HarkonenBade/porta-jelly/README.md

# porta-jelly

Rework of @cillian64 's excellent mini-jelly board (https://github.com/cillian64/cyberjelly/tree/master/mini_jellies/mini_jellies) tweaked to include an IP5306 based Lipo charge and boost setup to make a portable LED strip driving system with built in battery charging.
