HarkonenBade/porta-jelly/porta-jelly.pdf

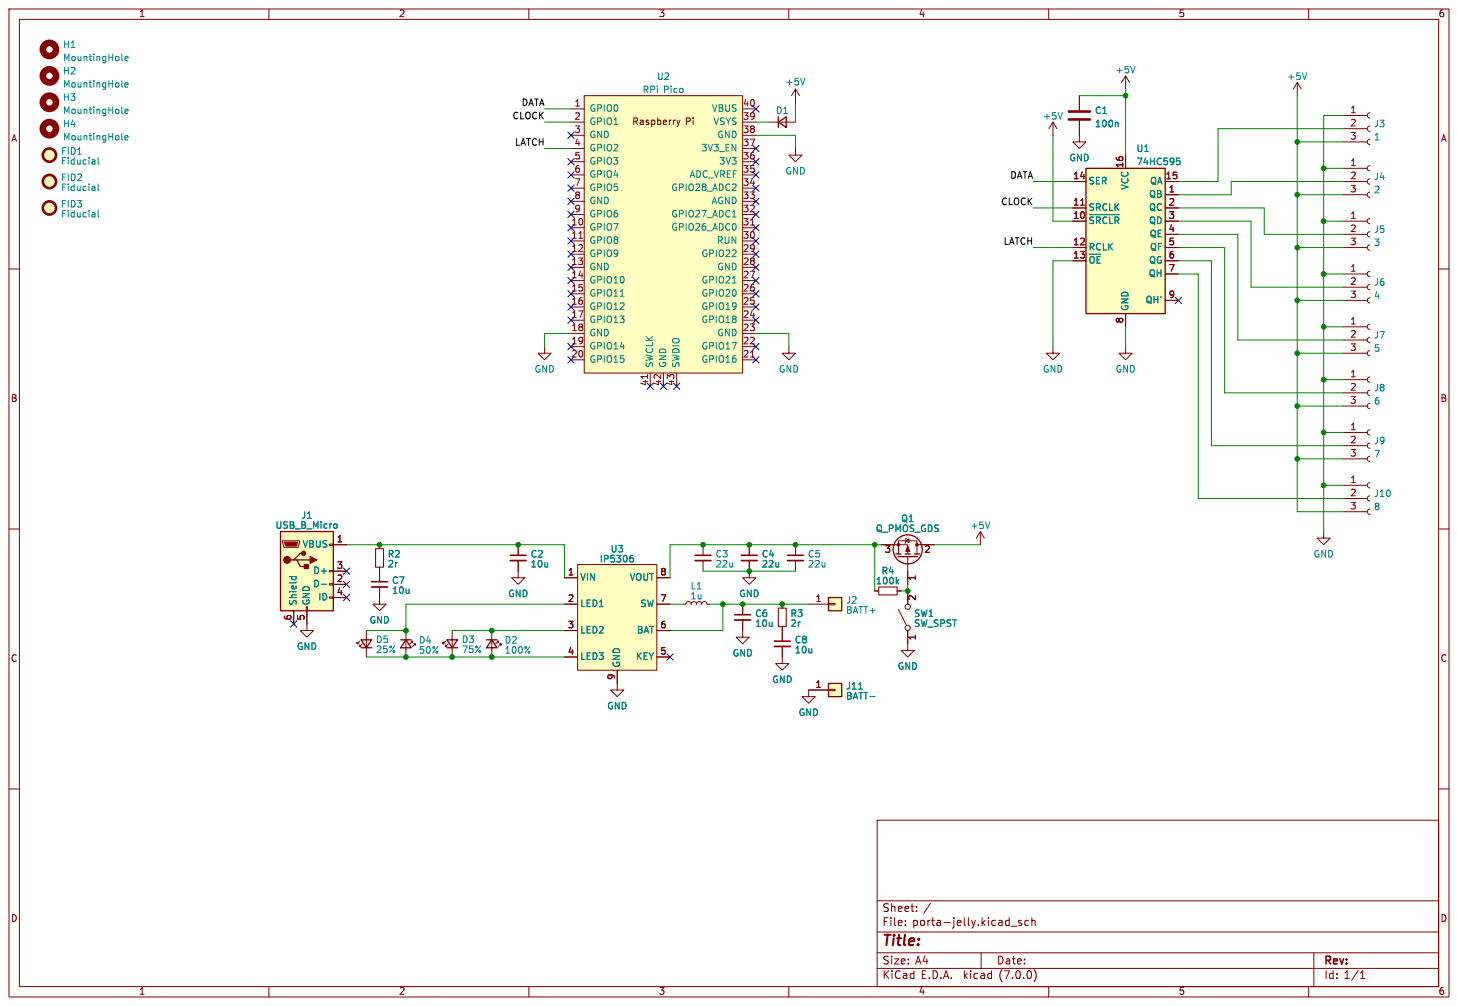
[picture p1: page 1]
