HarkonenBade/porta-jelly/porta-jelly.kicad_pcb

## KiCad design porta-jelly.kicad_pcb (2023-03-20)

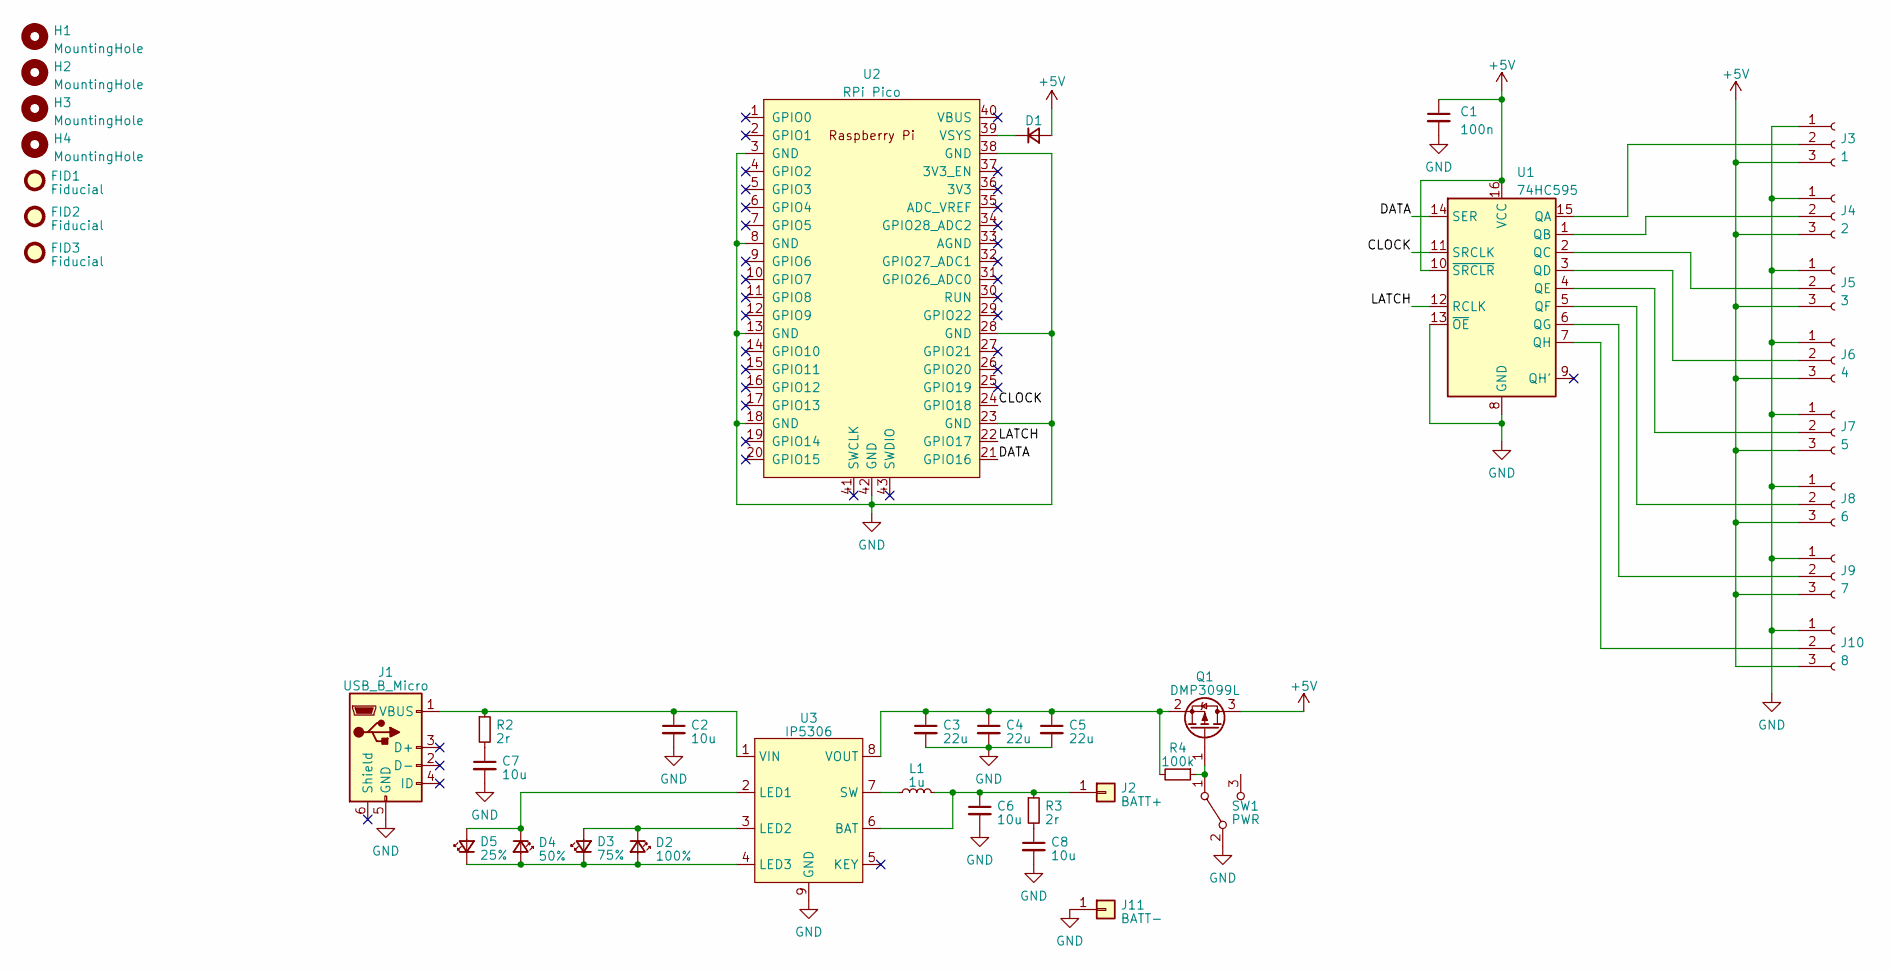
[picture p2: schematic porta-jelly.kicad_sch]

Parts:
C1: 100n; C_0603_1608Metric
C2, C6, C7, C8: 10u; C_0603_1608Metric; LCSC C19702
C3, C4, C5: 22u; C_0805_2012Metric; LCSC C159801
D1: D_Small; D_0805_2012Metric; LCSC C146335
D2: 100%; LED_0805_2012Metric; LCSC C497961
D3: 75%; LED_0805_2012Metric; LCSC C497961
D4: 50%; LED_0805_2012Metric; LCSC C497961
D5: 25%; LED_0805_2012Metric; LCSC C497961
FID1, FID2, FID3: Fiducial; Fiducial_1mm_Mask2mm
H1, H2, H3, H4: MountingHole; MountingHole_3.2mm_M3
J1: USB_B_Micro; USB_Micro-B_Molex-105017-0001; LCSC C136000
J2: BATT+; Bonded_Pad
J3: 1; Molex_KK-254_AE-6410-03A_1x03_P2.54mm_Vertical
J4: 2; Molex_KK-254_AE-6410-03A_1x03_P2.54mm_Vertical
J5: 3; Molex_KK-254_AE-6410-03A_1x03_P2.54mm_Vertical
J6: 4; Molex_KK-254_AE-6410-03A_1x03_P2.54mm_Vertical
J7: 5; Molex_KK-254_AE-6410-03A_1x03_P2.54mm_Vertical
J8: 6; Molex_KK-254_AE-6410-03A_1x03_P2.54mm_Vertical
J9: 7; Molex_KK-254_AE-6410-03A_1x03_P2.54mm_Vertical
J10: 8; Molex_KK-254_AE-6410-03A_1x03_P2.54mm_Vertical
J11: BATT-; Bonded_Pad
L1: 1u; LQH44PH1R0MPRL; LCSC C1857967
Q1: DMP3099L; SOT-23; LCSC C155244
R2, R3: 2r; R_0603_1608Metric; LCSC C307263
R4: 100k; R_0603_1608Metric
SW1: PWR; SK12D07VG5; LCSC C3020419
U1: 74HC595; SOIC-16_3.9x9.9mm_P1.27mm; LCSC C5947
U2: RPi Pico; RPi_Pico_SMD_TH
U3: IP5306; SOIC-8-1EP_3.9x4.9mm_P1.27mm_EP2.29x3mm_ThermalVias; LCSC C181692

Connections:
+5V: C1.1, D1.2 (A), J3.3, J4.3, J5.3, J6.3, J7.3, J8.3, J9.3, J10.3, Q1.3 (D), U1.10 (~SRCLR), U1.16 (VCC)
/CLOCK: U1.11 (SRCLK), U2.24 (GPIO18)
/DATA: U1.14 (SER), U2.21 (GPIO16)
/LATCH: U1.12 (RCLK), U2.22 (GPIO17)
GND: C1.2, C2.2, C3.2, C4.2, C5.2, C6.2, C7.2, C8.2, J1.5 (GND), J3.1, J4.1, J5.1, J6.1, J7.1, J8.1, J9.1, J10.1, J11.1, SW1.2 (B), U1.8 (GND), U1.13 (~OE), U2.3 (GND), U2.8 (GND), U2.13 (GND), U2.18 (GND), U2.23 (GND), U2.28 (GND), U2.38 (GND), U2.42 (GND), U3.9 (GND)
unnamed: C7.1, R2.2
unnamed: C8.1, R3.2
unnamed: D1.1 (K), U2.39 (VSYS)
unnamed: D2.2 (A), D3.1 (K), D4.2 (A), D5.1 (K), U3.4 (LED3)
unnamed: D2.1 (K), D3.2 (A), U3.3 (LED2)
unnamed: D4.1 (K), D5.2 (A), U3.2 (LED1)
unnamed: C2.1, J1.1 (VBUS), R2.1, U3.1 (VIN)
unnamed: C6.1, J2.1, L1.2, R3.1, U3.6 (BAT)
unnamed: J3.2, U1.15 (QA)
unnamed: J4.2, U1.1 (QB)
unnamed: J5.2, U1.2 (QC)
unnamed: J6.2, U1.3 (QD)
unnamed: J7.2, U1.4 (QE)
unnamed: J8.2, U1.5 (QF)
unnamed: J9.2, U1.6 (QG)
unnamed: J10.2, U1.7 (QH)
unnamed: Q1.1 (G), R4.1, SW1.1 (A)
unnamed: C3.1, C4.1, C5.1, Q1.2 (S), R4.2, U3.8 (VOUT)
unnamed: L1.1, U3.7 (SW)

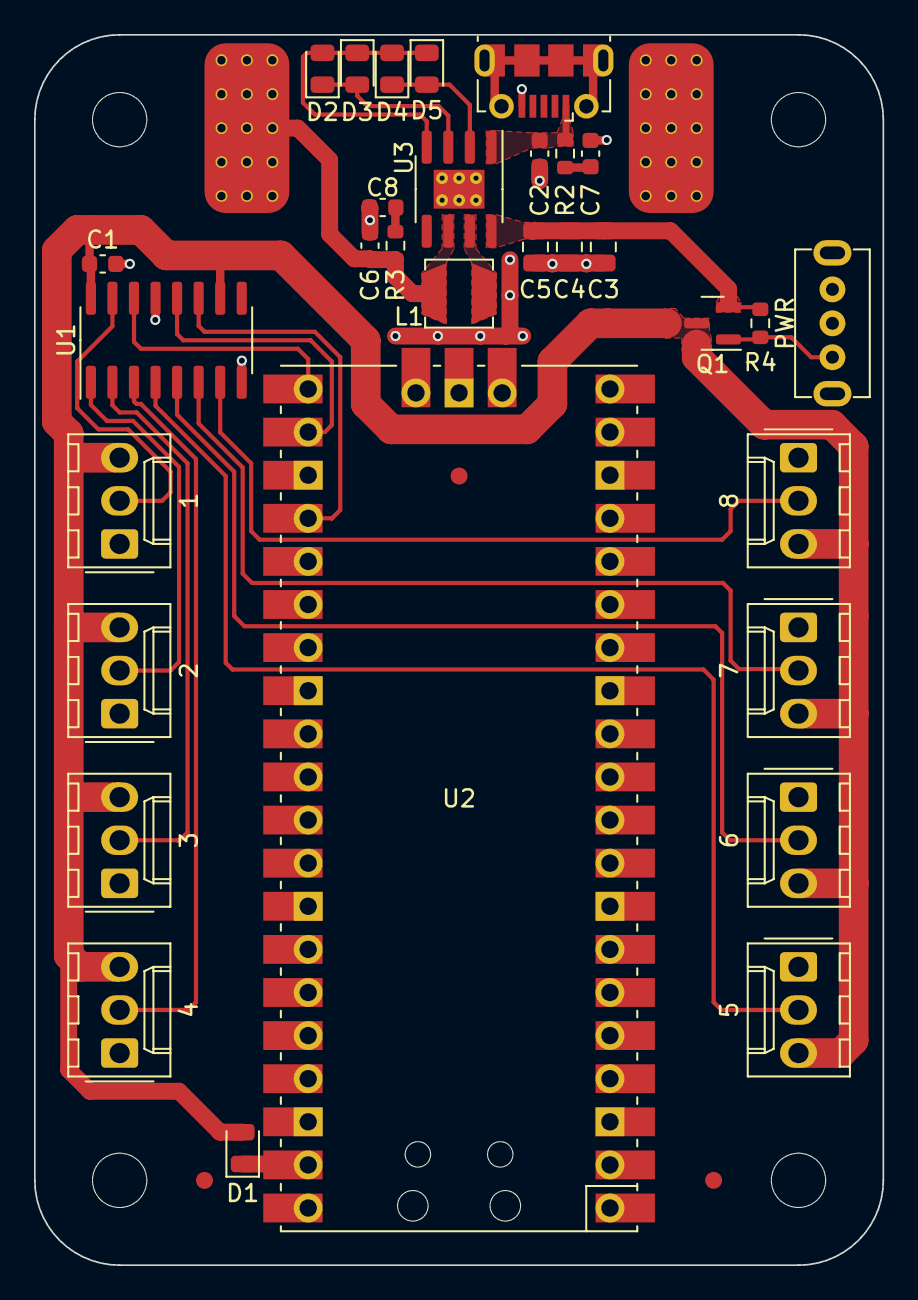
[picture p3: board porta-jelly.kicad_pcb from above]

Board: 2 copper layers, 50.0 x 72.5 mm, 40 parts (0 on the bottom side), 24 nets.
