HarkonenBade/porta-jelly/(threads)

Thread 1 (2023-05-15):

Clk Shift Pin Error

HarkonenBade, 2023-05-15:
Clk and Sft pins must directly follow data pin in order, they need to be swapped as much as it sucks for routing.
