HarkonenBade/porta-jelly/(commit log)

2023-03-05 Initial Work - Schematic mostly complete sans finding specific parts for a few bits - PCB proposed layout of parts done, routing in progress
    [porta-jelly.kicad_pcb, porta-jelly.kicad_sch]
2023-03-15 Revised board design
    [porta-jelly.kicad_pcb, porta-jelly.kicad_sch]
2023-03-20 Final board, schematic updates, LCSC order codes
    [porta-jelly.kicad_pcb, porta-jelly.kicad_sch]
2023-03-20 Final gerbers and pos file
    [porta-jelly-B_Cu.gbl, porta-jelly-B_Mask.gbs, porta-jelly-B_Paste.gbp, porta-jelly-B_Silkscreen.gbo, porta-jelly-Edge_Cuts.gm1, porta-jelly-F_Cu.gtl, porta-jelly-F_Mask.gts, porta-jelly-F_Paste.gtp]
